Pyrodrifter/PyroRotator/(commit log)

2026-06-30 PyroRotator: ESP32 Az/El antenna rotator firmware
    Open-loop NEMA 17 + TMC2209 (standalone StealthChop2 + 1/256 MicroPlyer), EL
    limit-switch homing, compass-set AZ zero. Web app + rotctld/SuperRot TCP :4533 +
    EasyComm II serial. Two-stage gentle homing; SuperRot continuous-motion support.
2026-06-30 docs: add logo, README (BOM + pin map + build), and CNC-shield pinout PDF
2026-07-09 Azimuth free shortest-path; el clamp only; two-stage homing already in
    - gotoAzEl (web/rotctld/park/jog): take the SHORTEST path (nearest equivalent to
    current az), so a manual goto to any heading turns the short way and may go
    negative — 0->330 goes -30, not +330.
    - Remove the azimuth travel clamp entirely (free 360, negative allowed); only
    elevation is bounded (0..elMax, up to 180 for flip-over). Streamed SuperRot 'A'
    setpoints stay absolute — the host resolves their continuity.
    [PyroRotator.ino]
